PaulMiron/esp32-wled-rgb-controller/docs/proiectv2.csv

Reference | Qty | Value | DNP | Exclude from BOM | Exclude from Board | Footprint | Datasheet
IRRECIEVER1 | 1 | Conn_01x03_Pin |  |  |  | Connector_Wire:SolderWire-0.5sqmm_1x03_P4.8mm_D0.9mm_OD2.3mm
J1 | 1 | Barrel_Jack |  |  |  | Connector_BarrelJack:BarrelJack_Horizontal
J2 | 1 | Screw_Terminal_01x04 |  |  |  | TerminalBlock_Phoenix:TerminalBlock_Phoenix_MKDS-1,5-4_1x04_P5.00mm_Horizontal
Q1,Q2,Q3 | 3 | IRLZ44N |  |  |  | Package_TO_SOT_THT:TO-220-3_Vertical | http://www.irf.com/product-info/datasheets/data/irlz44n.pdf
R1,R3,R5 | 3 | 220 |  |  |  | Resistor_THT:R_Axial_DIN0207_L6.3mm_D2.5mm_P10.16mm_Horizontal
R2,R4,R6 | 3 | 10K |  |  |  | Resistor_THT:R_Axial_DIN0207_L6.3mm_D2.5mm_P10.16mm_Horizontal
RGB1 | 1 | Conn_01x04 |  |  |  | Connector_Wire:SolderWire-0.5sqmm_1x04_P4.8mm_D0.9mm_OD2.3mm
U1 | 1 | ESP32-DevKitC |  |  |  | PCM_Espressif:ESP32-DevKitC | https://docs.espressif.com/projects/esp-idf/zh_CN/latest/esp32/hw-reference/esp32/get-started-devkitc.html
