PaulMiron/esp32-wled-rgb-controller/hardware/proiectv2.kicad_pcb

## KiCad design hardware/proiectv2.kicad_pcb (2026-10-24)

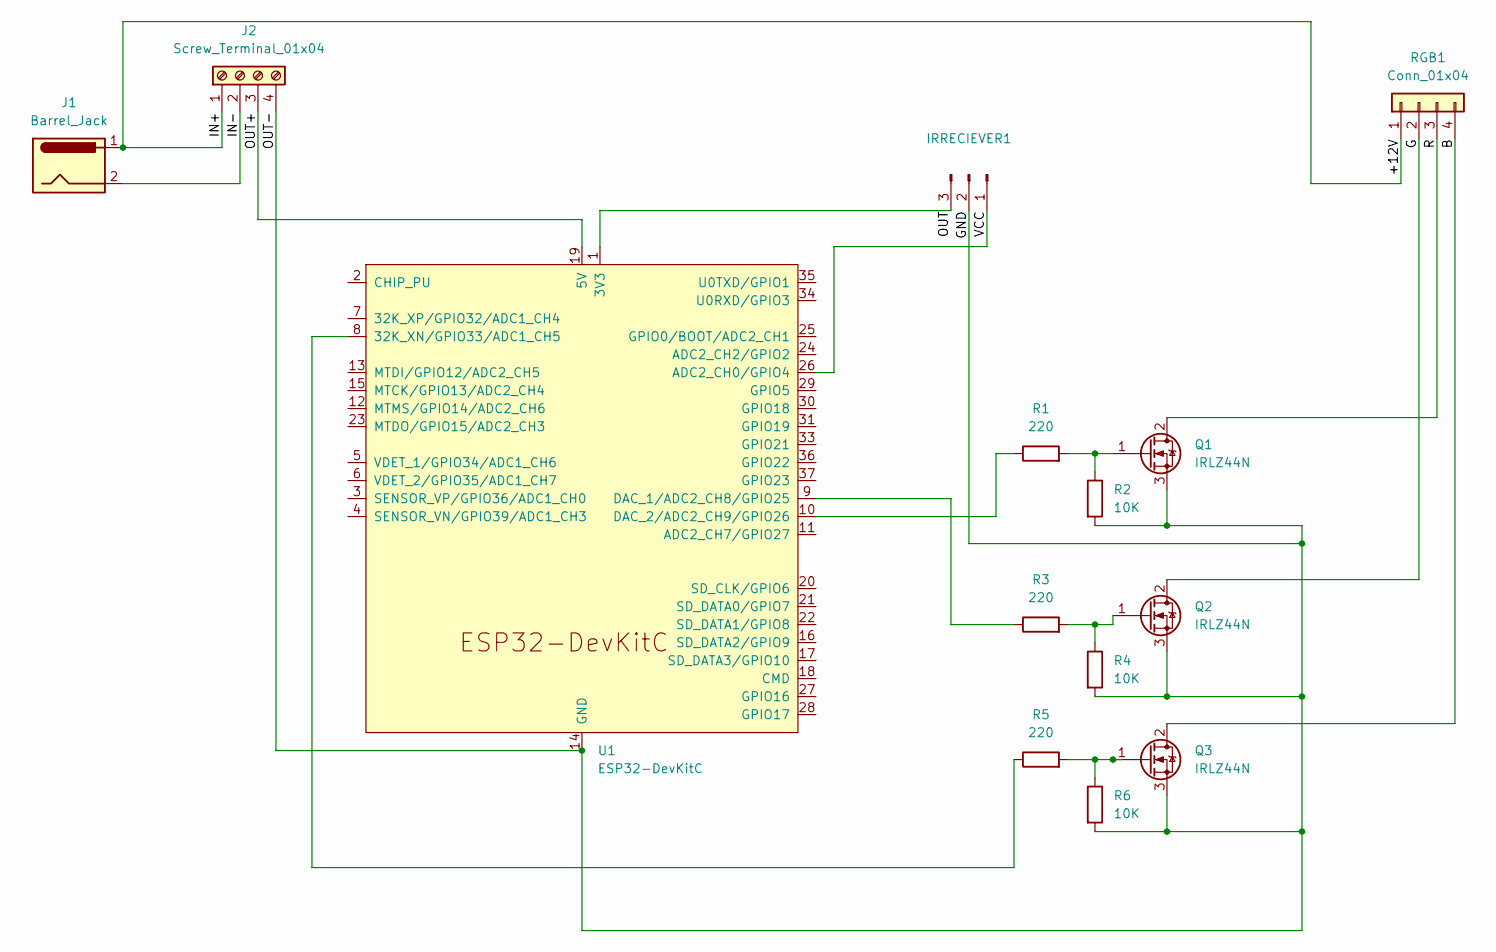
[picture p5: schematic proiectv2.kicad_sch]

Parts:
IRRECIEVER1: Conn_01x03_Pin; SolderWire-0.5sqmm_1x03_P4.8mm_D0.9mm_OD2.3mm
J1: Barrel_Jack; BarrelJack_Horizontal
J2: Screw_Terminal_01x04; TerminalBlock_Phoenix_MKDS-1,5-4_1x04_P5.00mm_Horizontal
Q1, Q2, Q3: IRLZ44N; TO-220-3_Vertical
R1, R3, R5: 220; R_Axial_DIN0207_L6.3mm_D2.5mm_P10.16mm_Horizontal
R2, R4, R6: 10K; R_Axial_DIN0207_L6.3mm_D2.5mm_P10.16mm_Horizontal
RGB1: Conn_01x04; SolderWire-0.5sqmm_1x04_P4.8mm_D0.9mm_OD2.3mm
U1: ESP32-DevKitC

Connections:
/+12V: J1.1, J2.1, RGB1.1; also elsewhere on the board
/B: Q3.2 (D), RGB1.4
/G: Q2.2 (D), RGB1.2
/GND: IRRECIEVER1.2, J2.4, Q1.3 (S), Q2.3 (S), Q3.3 (S), R2.2, R4.2, R6.2, U1.14 (GND), U1.32 (GND), U1.38 (GND)
/IN-: J1.2, J2.2; also elsewhere on the board
/OUT: IRRECIEVER1.3, U1.1 (3V3)
/OUT+: J2.3, U1.19 (5V)
/R: Q1.2 (D), RGB1.3
/VCC: IRRECIEVER1.1, U1.26 (ADC2_CH0/GPIO4)
unnamed: Q1.1 (G), R1.2, R2.1
unnamed: Q2.1 (G), R3.2, R4.1
unnamed: Q3.1 (G), R5.2, R6.1
unnamed: R5.1, U1.8 (32K_XN/GPIO33/ADC1_CH5)
unnamed: R3.1, U1.9 (DAC_1/ADC2_CH8/GPIO25)
unnamed: R1.1, U1.10 (DAC_2/ADC2_CH9/GPIO26)

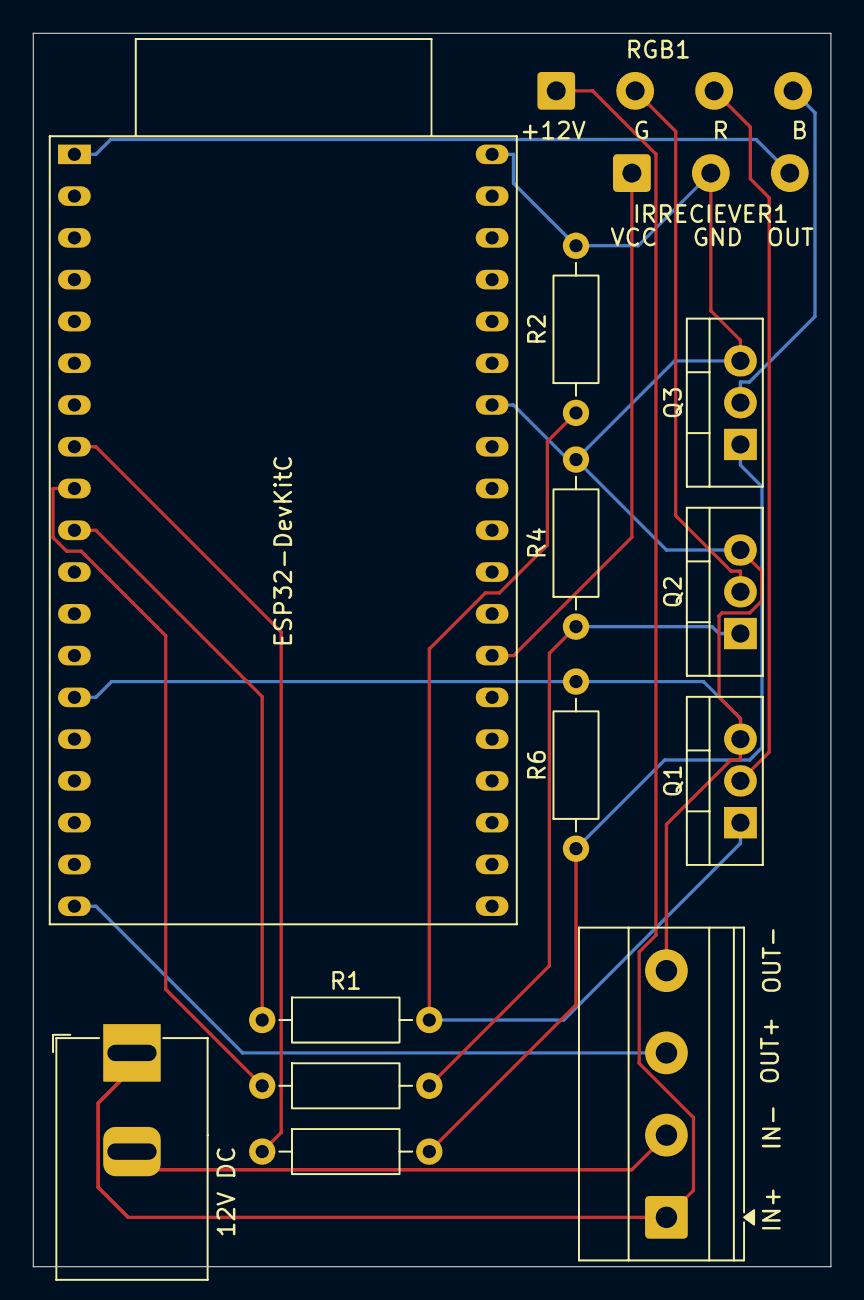
[picture p6: board proiectv2.kicad_pcb from above]

Board: 2 copper layers, 48.5 x 75.0 mm, 14 parts (0 on the bottom side), 15 nets.

Other parts of the board:
12V DC: Barrel_Jack; BarrelJack_Horizontal

Their connections:
/+12V: 12V DC.1; also elsewhere on the board
/IN-: 12V DC.2; also elsewhere on the board
